jorgejaqa/PiHat/README.md

# PiHat
Raspberry Pi Automation HAT 5 Relays, 8 optocouplers, 24vac power supply, and more
