jorgejaqa/PiHat/Raspberry 4 Pi Model B Hat/RASPBERRY 4 PI HAT.kicad_pcb

## KiCad design Raspberry 4 Pi Model B Hat/RASPBERRY 4 PI HAT.kicad_pcb (2021-06-14)

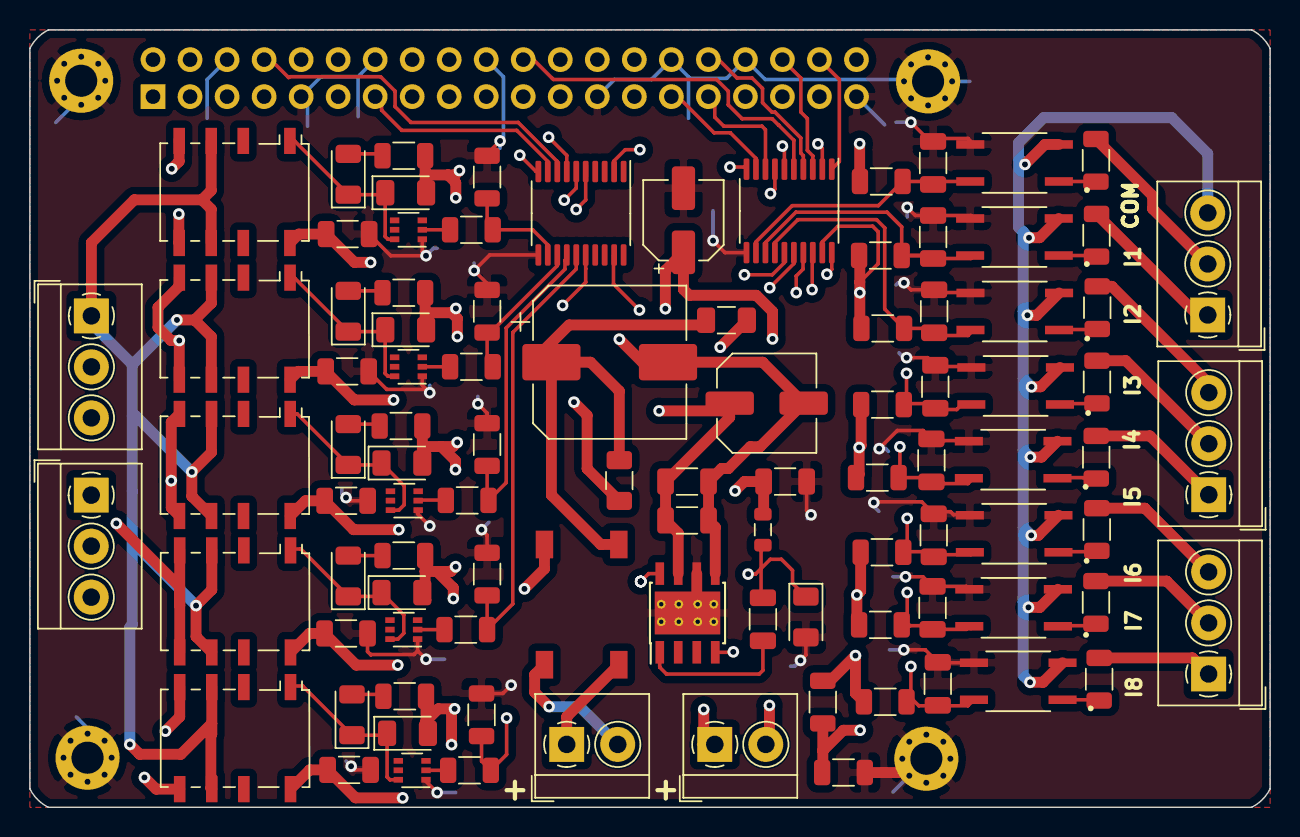
[picture p1: board RASPBERRY 4 PI HAT.kicad_pcb from above]

Board: 4 copper layers, 85.1 x 53.3 mm, 101 parts (1 on the bottom side), 76 nets.

Parts:
C1, C2, C3, C4, C5, C6, C7, C8: 100nF; C_1206_3216Metric
C9: 270uF; CP_Elec_10x10
C10, C13, C17, C18, C19, C20: 10uF; C_1206_3216Metric
C11, C15: 4.7uF; C_1206_3216Metric
C12: 0.01uF; C_1206_3216Metric
C14: 220uF; CP_Elec_5x5.9
C16: 47uF; C_Elec_6.3x5.8
D1: B340; D_1206_3216Metric
D2, D3, D5, D10, D11: DIODE; D_1206_3216Metric
D6, D7, D8, D9, D14: LED; LED_1206_3216Metric
DB107S1: DB107S; DIOB_DB107S
F1, F2: 1A; Fuse_1206_3216Metric
H1, H2, H3, H4: MountingHole_Pad; MountingHole_2.2mm_M2_Pad_Via
J1, J2: Screw_Terminal_01x02; TerminalBlock_4Ucon_1x02_P3.50mm_Horizontal
J3, J4, J5, J6, J8: Screw_Terminal_01x03; TerminalBlock_4Ucon_1x03_P3.50mm_Horizontal
J7: Conn_02x20_Odd_Even; PinSocket_2x20_P2.54mm_Vertical
K1, K2, K3, K4, K5: G6K-2; Relay_DPDT_Omron_G6K-2F-Y
L2: 22uH; L_0805_2012Metric
Q1, Q2, Q3, Q4, Q5: PMBT3904YS; SOT-363_SC-70-6
R1, R2, R3, R4, R5, R6, R7, R8: 1.2K; R_1206_3216Metric
R9, R10, R11, R12, R13, R14, R15, R16: 5K; R_1206_3216Metric
R17, R19, R20, R22, R31, R32: 10K; R_1206_3216Metric
R18: 3.3K; R_1206_3216Metric
R23, R25, R29, R35: 2K; R_1206_3216Metric
R24, R26, R30, R36, R38: 1K; R_1206_3216Metric
R37: 4.7K; R_1206_3216Metric
U1, U3: TXS0108EPW; TSSOP-20_4.4x6.5mm_P0.65mm
U2: TPS5430DDA; TI_SO-PowerPAD-8_ThermalVias
U4, U5, U6, U7, U8, U9, U10, U11: EL817; SOP254P700X200-4N

Connections:
24VDC+: F2.2, J1.1
24VDC-: C9.2, C11.2, C15.2, C16.2, DB107S1.-, J1.2, U2.5
+3V3: J7.1, J7.17, U1.2, U1.10, U3.2, U3.10
+5V: C10.1, C13.1, C14.1, C17.1, C18.1, C19.1, C20.1, D2.2, D3.2, D5.2, D10.2, D11.2, J7.2, J7.4, K1.8, K2.8, K3.8, K4.8, K5.8, L2.2, R9.1, R10.1, R11.1, R12.1, R13.1, R14.1, R15.1, R16.1, R17.1, R23.1, R25.1, R29.1, R35.1, R37.1, U1.19, U3.19
A0: C1.1, R9.2, U1.12, U4.4
A1: C2.1, R10.2, U1.13, U5.4
A2: C3.1, R11.2, U1.14, U6.4
A3: C4.1, R12.2, U1.15, U7.4
A4: C5.1, R13.2, U1.16, U8.4
A5: C6.1, R14.2, U1.17, U9.4
A6: C7.1, R15.2, U1.18, U10.4
A7: C8.1, R16.2, U1.20, U11.4
AC+: DB107S1.~, J2.1
AC-: DB107S1.~., J2.2
COM1: J3.3, U4.2, U5.2, U6.2, U7.2, U8.2, U9.2, U10.2, U11.2
COM2: J6.1, K1.3, K1.6, K2.3, K2.6, K3.3, K3.6, K4.3, K4.6, K5.3, K5.6
GND: C1.2, C2.2, C3.2, C4.2, C5.2, C6.2, C7.2, C8.2, C10.2, C13.2, C14.2, C17.2, C18.2, C19.2, C20.2, D1.2, H1.1, H2.1, H3.1, H4.1, J7.6, J7.9, J7.14, J7.20, J7.25, J7.30, J7.34, J7.39, Q1.1, Q2.1, Q3.1, Q4.1, Q5.1, R18.2, R19.2, R20.2, R22.2, R31.2, R32.2, U1.11, U2.6, U2.9, U3.11, U4.3, U5.3, U6.3, U7.3, U8.3, U9.3, U10.3, U11.3
GPIO3: J7.5, U3.5
GPIO4: J7.7, U3.6
GPIO5: J7.29, U1.9
GPIO6: J7.31, U1.8
GPIO12: J7.32, U1.4
GPIO13: J7.33, U1.7
GPIO14: J7.8, U3.8
GPIO15: J7.10, U3.7
GPIO16: J7.36, U1.3
GPIO20: J7.38, U1.1
GPIO25: J7.22, U1.5
GPIO26: J7.37, U1.6
GPIO27: J7.13, U3.9
I1: J3.2, R1.1
I2: J3.1, R2.1
I3: J4.3, R3.1
I4: J4.2, R4.1
I5: J4.1, R5.1
I6: J5.3, R6.1
I7: J5.2, R7.1
I8: J5.1, R8.1
unnamed: C9.1, DB107S1.+, F1.1, F2.1
unnamed: C11.1, C15.1, C16.1, F1.2, U2.7
unnamed: C12.1, D1.1, L2.1, U2.8
unnamed: C12.2, U2.1
unnamed: D6.2, R23.2
unnamed: D7.2, R25.2
unnamed: D9.2, R29.2
unnamed: D14.2, R35.2
unnamed: D8.2, R37.2
unnamed: Q1.2, R24.2
unnamed: Q2.2, R26.2
unnamed: Q3.2, R38.2
unnamed: Q4.2, R30.2
unnamed: Q5.2, R36.2
unnamed: R1.2, U4.1
unnamed: R2.2, U5.1
unnamed: R3.2, U6.1
unnamed: R4.2, U7.1
unnamed: R5.2, U8.1
unnamed: R6.2, U9.1
unnamed: R7.2, U10.1
unnamed: R8.2, U11.1
RL1: D2.1, D6.1, K1.1, Q1.6
RL2: D3.1, D7.1, K2.1, Q2.6
RL3: D8.1, D11.1, K3.1, Q3.6
RL4: D5.1, D9.1, K4.1, Q4.6
RL5: D10.1, D14.1, K5.1, Q5.6
VS: R17.2, R18.1, U2.4
Y0: R19.1, R24.1, U3.12
Y1: R20.1, R26.1, U3.13
Y2: R32.1, R38.1, U3.14
Y3: R22.1, R30.1, U3.15
Y4: R31.1, R36.1, U3.16
YD1: J6.2, K1.4, K1.5
YD2: J6.3, K2.4, K2.5
YD3: J8.1, K3.4, K3.5
YD4: J8.2, K4.4, K4.5
YD5: J8.3, K5.4, K5.5
